clawntl/BLDC-Driver/Hardware/production/bom.csv

Designator | Footprint | Quantity | Value | LCSC Part #
C1, C13, C14, C15, C17, C27, C29, C31, C32 | 0402 | 9 | 100nF | C307331
C10, C11, C26, C28, C3, C30, C6 | 0402 | 7 | 1uF | C52923
C12, C21, C22, C23, C24 | 0805 | 5 | 10uF | C440198
C16 | 0603 | 1 | 10uF | C96446
C18, C19, C20 | 0402 | 3 | 22pF | C1555
C2, C5 | 0603 | 2 | 47nF | C1622
C33, C34 | 0402 | 2 | 10pF | C32949
C4 | 0603 | 1 | 22uF | C59461
C7 | 0805 | 1 | 4.7uF | C1779
C8, C9 | 0402 | 2 | 100pF | C1546
D1 | D_SOD-323 | 1 | 1N4148WS | C2128
D2 | D_SOD-323_Zener | 1 | BZT52B5V1S | C19077434
D3 | 0603 | 1 | Red LED | C2286
D4 | 0603 | 1 | White LED | C2290
IC2 | QFN50P500X700X100-41N-D | 1 | DRV8316CRRGFR | C5447274
J1 | USB_C_Receptacle_GCT_USB4105-xx-A_16P_TopMnt_Horizontal | 1 | USB_C_Receptacle_USB2.0_16P | C393939
J3, J4 | JST_PH_S3B-PH-K_1x03_P2.00mm_Horizontal | 2 | Conn_01x03 | C157929
L1 | L_Changjiang_FNR3015S | 1 | 47uH | C96151
Q1 | SOT-23 | 1 | AO3401A | C15127
R1, R2 | 0805 | 2 | 60.4R | C72998
R10, R13, R16, R7, R9 | 0402 | 5 | 10k | C25744
R11, R12, R14, R15, R18, R19, R6 | 0402 | 7 | 330R | C25104
R17, R8 | 0402 | 2 | 100k | C25741
R3, R4, R5 | 0402 | 3 | 5.1k | C25905
SW1, SW2, SW3 | TS-1088-AR02016 | 3 | TS-1088-AR02016 | C720477
U1 | QFN-48-1EP_7x7mm_P0.5mm_EP5.6x5.6mm | 1 | STM32G431CBUx | C529356
U2 | SOIC-8_3.9x4.9mm_P1.27mm | 1 | TJA1051T-3 | C38695
U4 | SOT-23-3 | 1 | XC6206P332MR-G | C5446
X1 | Crystal_SMD_3225-4Pin_3.2x2.5mm | 1 | SMD3225-4 | C13738
