clawntl/BLDC-Driver/Hardware/DRV8316CRRGFR/DRV8316CRRGFR.step

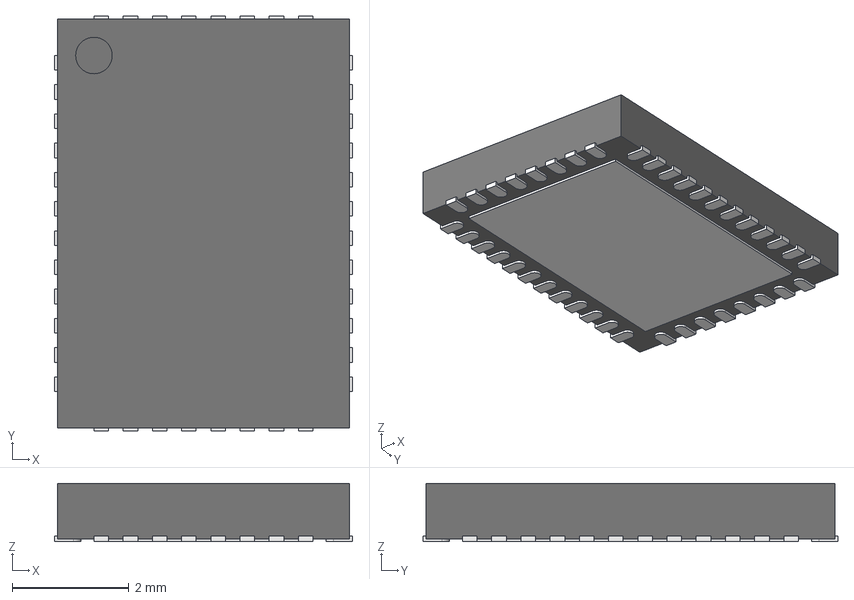
[picture p2: CAD file, 2025-07-08]
Hardware/DRV8316CRRGFR/DRV8316CRRGFR.step
5.10 x 7.10 x 1.00 mm
ThermalPin
PinsArrayLR
PinsArrayTB
