clawntl/BLDC-Driver/Hardware/v0.2_Custom_Motor_Driver_DRV8316_STM32G4.step

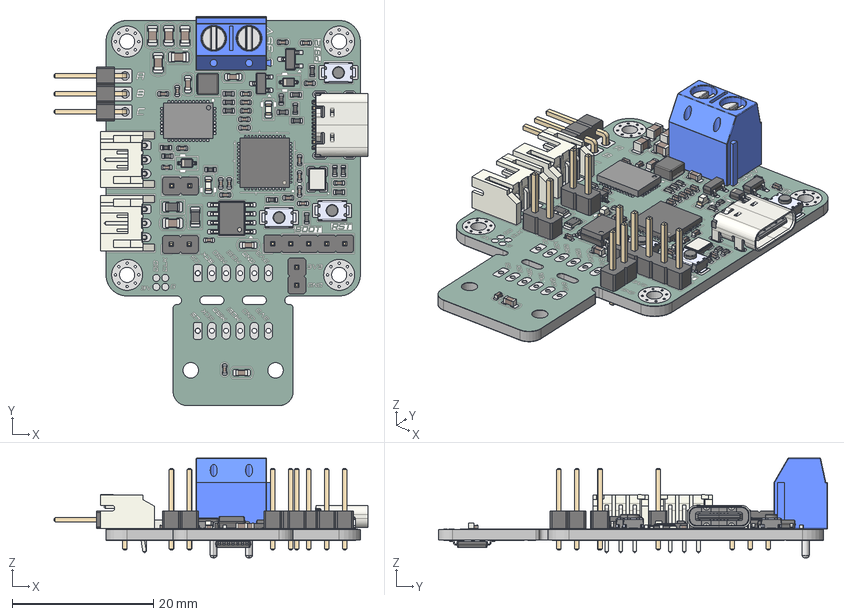
[picture p3: CAD file, 2025-07-08]
Hardware/v0.2_Custom_Motor_Driver_DRV8316_STM32G4.step
44.4 x 55.1 x 14.1 mm
PinHeader_1x05_P2.54mm_Vertical
C_0402_1005Metric x 23
TS-1088-AR02016--3DModel-STEP-269445 x 3
R_0402_1005Metric x 17
ThermalPin
PinsArrayLR
PinsArrayTB
C_0805_2012Metric x 6
R_0805_2012Metric x 2
C_0603_1608Metric x 4
D_SOD-323 x 2
USB_C_Receptacle_GCT_USB4105-xx-A_16P_TopMnt_Horizontal
SOIC-8_3.9x4.9mm_P1.27mm
Crystal_SMD_3225-4Pin_3.2x2.5mm
PinHeader_1x02_P2.54mm_Vertical x 3
LED_0603_1608Metric x 2
JST_PH_S3B-PH-K_1x03_P2.00mm_Horizontal x 2
L_Changjiang_FNR3015S
SOT-23-3
QFN-48-1EP_7x7mm_P0.5mm_EP5.15x5.15mm
SOT-23
PinHeader_1x03_P2.54mm_Horizontal
TSSOP-14_4.4x5mm_P0.65mm
v0.2_Custom_Motor_Driver_DRV8316_STM32G4_copper
v0.2_Custom_Motor_Driver_DRV8316_STM32G4_pad
v0.2_Custom_Motor_Driver_DRV8316_STM32G4_via
v0.2_Custom_Motor_Driver_DRV8316_STM32G4_silkscreen
v0.2_Custom_Motor_Driver_DRV8316_STM32G4_soldermask
v0.2_Custom_Motor_Driver_DRV8316_STM32G4_PCB
