clawntl/BLDC-Driver/schematic_v0.2.pdf

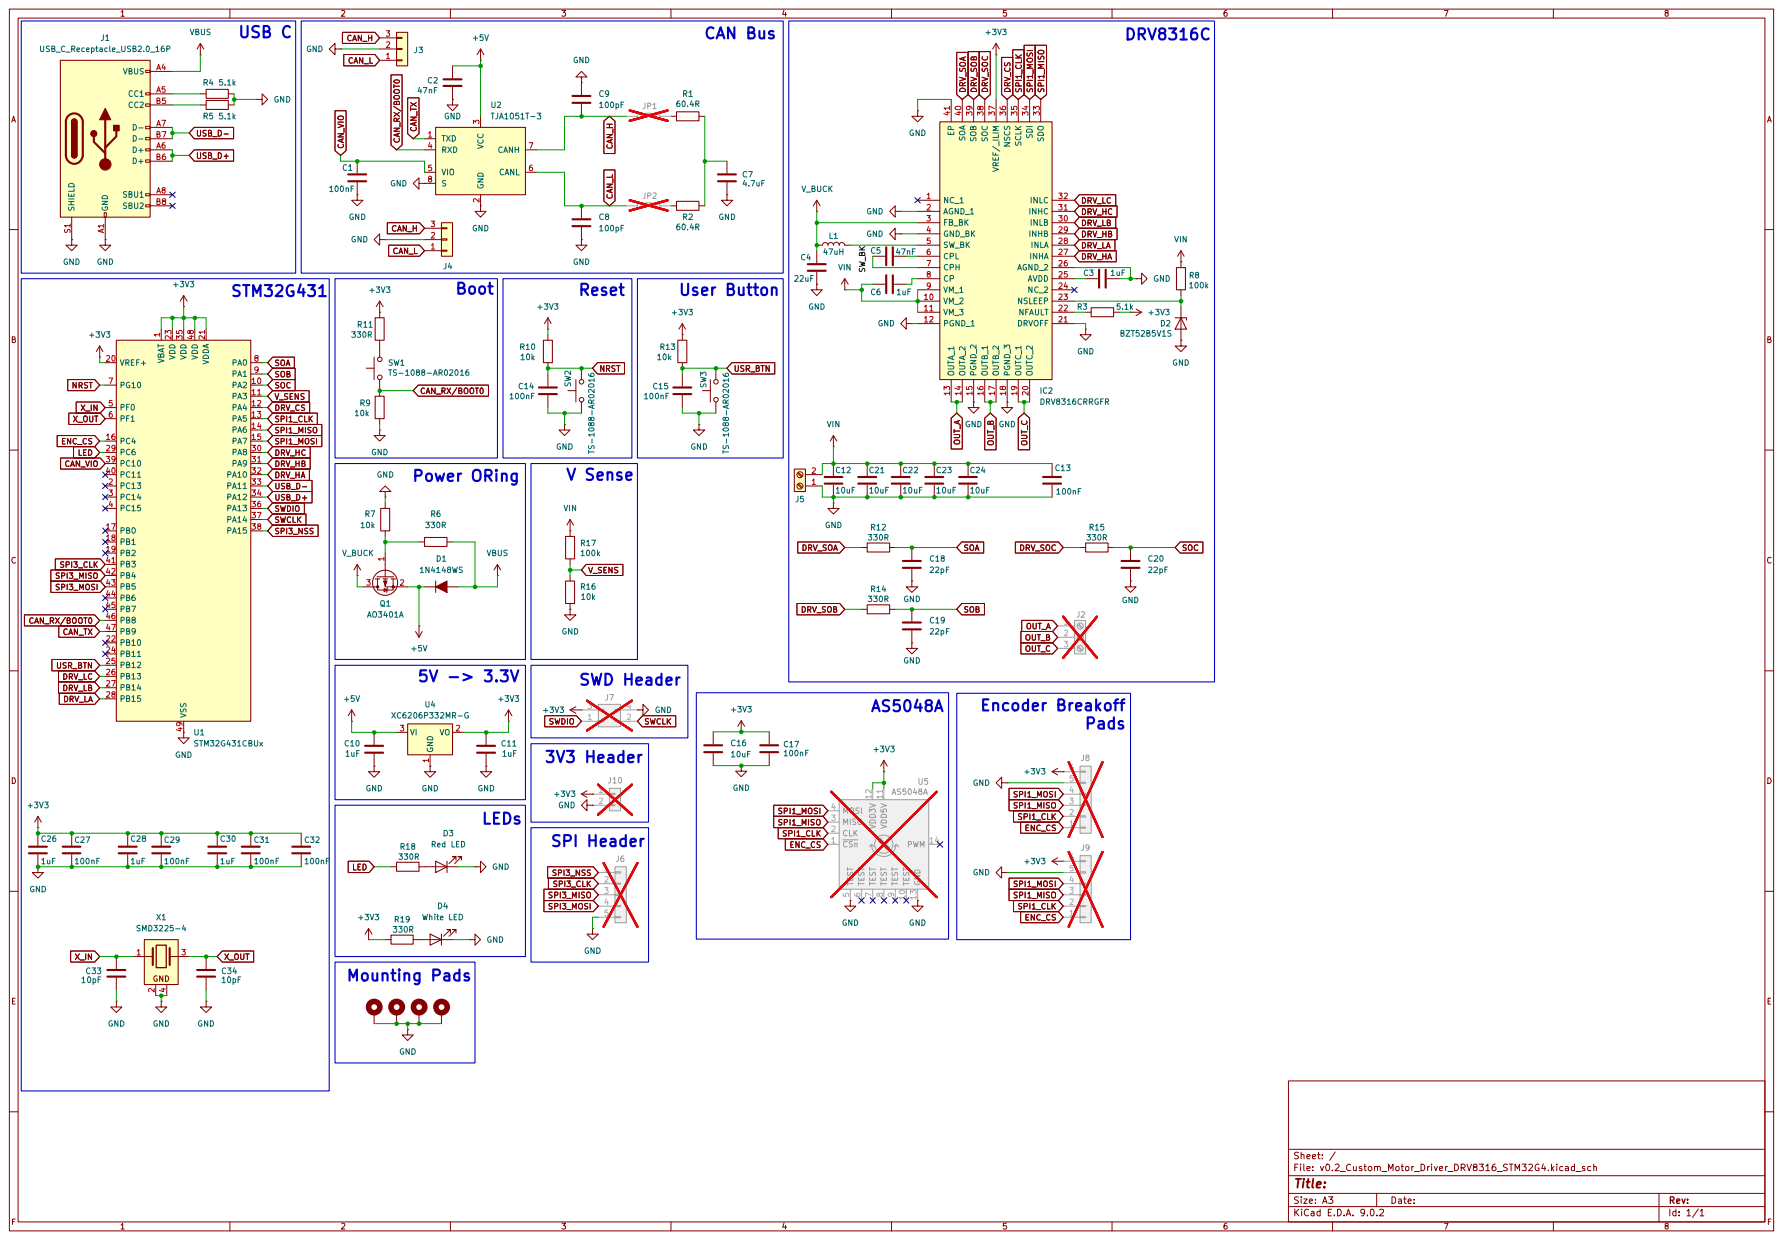
[picture p4: page 1]
