clawntl/BLDC-Driver/Hardware/v0.2_Custom_Motor_Driver_DRV8316_STM32G4.kicad_pcb

## KiCad design Hardware/v0.2_Custom_Motor_Driver_DRV8316_STM32G4.kicad_pcb (2025-07-08)

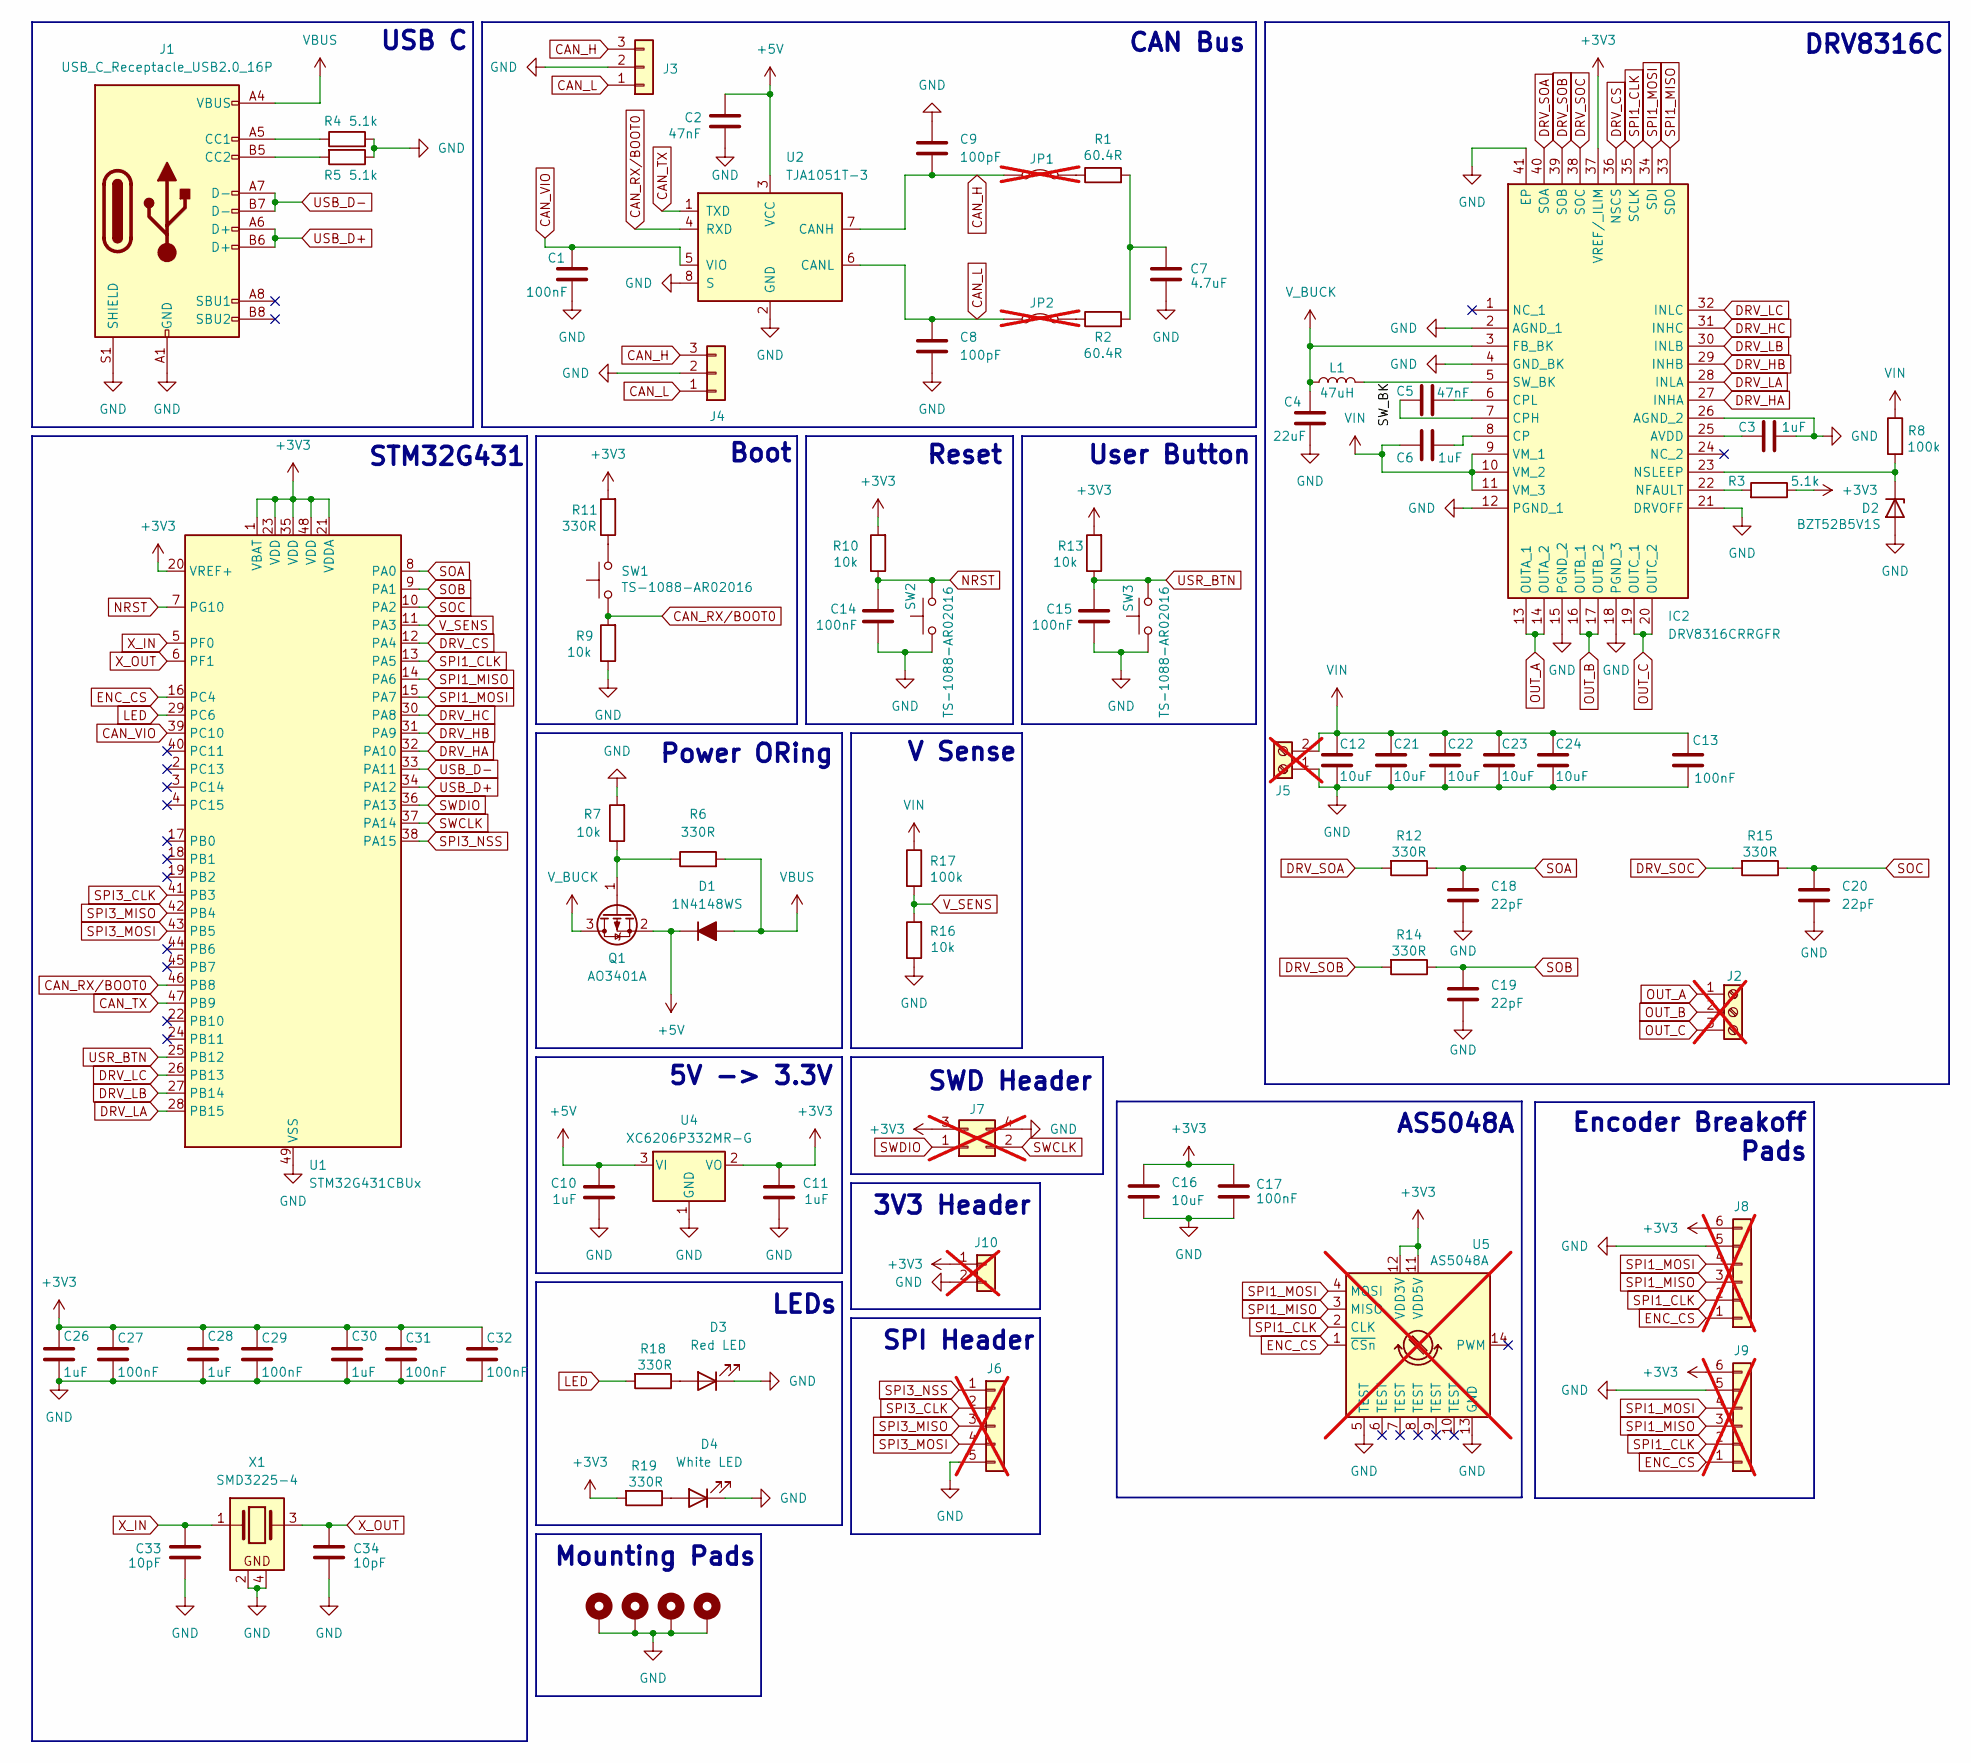
[picture p5: schematic v0.2_Custom_Motor_Driver_DRV8316_STM32G4.kicad_sch]

Parts:
C1, C13, C14, C15, C17, C27, C29, C31, C32: 100nF; C_0402_1005Metric; LCSC C307331
C2, C5: 47nF; C_0603_1608Metric; LCSC C1622
C3, C6, C10, C11, C26, C28, C30: 1uF; C_0402_1005Metric; LCSC C52923
C4: 22uF; C_0603_1608Metric; LCSC C59461
C7: 4.7uF; C_0805_2012Metric; LCSC C1779
C8, C9: 100pF; C_0402_1005Metric; LCSC C1546
C12, C21, C22, C23, C24: 10uF; C_0805_2012Metric; LCSC C440198
C16: 10uF; C_0603_1608Metric; LCSC C96446
C18, C19, C20: 22pF; C_0402_1005Metric; LCSC C1555
C33, C34: 10pF; C_0402_1005Metric; LCSC C32949
D1: 1N4148WS; D_SOD-323; LCSC C2128
D2: BZT52B5V1S; D_SOD-323_Zener; LCSC C19077434
D3: Red LED; LED_0603_1608Metric; LCSC C2286
D4: White LED; LED_0603_1608Metric; LCSC C2290
H1, H2, H3, H4: MountingHole_Pad; MountingHole_2.2mm_M2_Pad_Via
IC2: DRV8316CRRGFR; QFN50P500X700X100-41N-D; LCSC C5447274
J1: USB_C_Receptacle_USB2.0_16P; USB_C_Receptacle_GCT_USB4105-xx-A_16P_TopMnt_Horizontal; LCSC C393939
J2: Screw_Terminal_01x03; TerminalBlock_Xinya_XY308-2.54-3P_1x03_P2.54mm_Horizontal; not fitted
J3, J4: Conn_01x03; JST_PH_S3B-PH-K_1x03_P2.00mm_Horizontal; LCSC C157929
J5: Screw_Terminal_01x02; TerminalBlock_MaiXu_MX126-5.0-02P_1x02_P5.00mm; LCSC C3018698; not fitted
J6: Conn_01x05; PinHeader_1x05_P2.54mm_Vertical; not fitted
J7: Conn_02x02_Odd_Even; DebugHeader2x02_P1.27mm; not fitted
J8, J9: Conn_01x06; JST_PH_S6B-PH-K_1x06_P2.00mm_Horizontal Breakoff; not fitted
J10: Conn_01x02; PinHeader_1x02_P2.54mm_Vertical SLIM; not fitted
JP1, JP2: Jumper_2_Bridged; PinHeader_1x02_P2.54mm_Vertical; not fitted
L1: 47uH; L_Changjiang_FNR3015S; LCSC C96151
Q1: AO3401A; SOT-23; LCSC C15127
R1, R2: 60.4R; R_0805_2012Metric; LCSC C72998
R3, R4, R5: 5.1k; R_0402_1005Metric; LCSC C25905
R6, R11, R12, R14, R15, R18, R19: 330R; R_0402_1005Metric; LCSC C25104
R7, R9, R10, R13, R16: 10k; R_0402_1005Metric; LCSC C25744
R8, R17: 100k; R_0402_1005Metric; LCSC C25741
SW1, SW2, SW3: TS-1088-AR02016; LCSC C720477
U1: STM32G431CBUx; QFN-48-1EP_7x7mm_P0.5mm_EP5.6x5.6mm; LCSC C529356
U2: TJA1051T-3; SOIC-8_3.9x4.9mm_P1.27mm; LCSC C38695
U4: XC6206P332MR-G; SOT-23-3; LCSC C5446
U5: AS5048A; TSSOP-14_4.4x5mm_P0.65mm; not fitted
X1: SMD3225-4; Crystal_SMD_3225-4Pin_3.2x2.5mm; LCSC C13738

Connections:
+3V3: C11.2, C16.1, C17.1, C26.1, C27.1, C28.1, C29.1, C30.1, C31.1, C32.1, IC2.37 (VREF/_ILIM), J7.3, J8.6, J9.6, J10.1, R3.2, R10.2, R11.2, R13.2, R19.2, U1.1 (VBAT), U1.20 (VREF+), U1.21 (VDDA), U1.23 (VDD), U1.35 (VDD), U1.48 (VDD), U4.2 (VO), U5.11 (VDD5V), U5.12 (VDD3V)
+5V: C2.1, C10.2, D1.1 (K), Q1.2 (S), U2.3 (VCC), U4.3 (VI)
/SW_BK: IC2.5 (SW_BK), L1.2
CAN_H: C9.2, J3.3, J4.3, JP1.1 (A), U2.7 (CANH)
CAN_L: C8.1, J3.1, J4.1, JP2.1 (A), U2.6 (CANL)
CAN_RX/BOOT0: R9.2, SW1.1, U1.46 (PB8), U2.4 (RXD)
CAN_TX: U1.47 (PB9), U2.1 (TXD)
CAN_VIO: C1.1, U1.39 (PC10), U2.5 (VIO)
DRV_CS: IC2.36 (NSCS), U1.12 (PA4)
DRV_HA: IC2.27 (INHA), U1.32 (PA10)
DRV_HB: IC2.29 (INHB), U1.31 (PA9)
DRV_HC: IC2.31 (INHC), U1.30 (PA8)
DRV_LA: IC2.28 (INLA), U1.28 (PB15)
DRV_LB: IC2.30 (INLB), U1.27 (PB14)
DRV_LC: IC2.32 (INLC), U1.26 (PB13)
DRV_SOA: IC2.40 (SOA), R12.2
DRV_SOB: IC2.39 (SOB), R14.2
DRV_SOC: IC2.38 (SOC), R15.2
ENC_CS: J8.1, J9.1, U1.16 (PC4), U5.1 (~CSn)
GND: C1.2, C2.2, C3.2, C4.2, C7.2, C8.2, C9.1, C10.1, C11.1, C12.2, C13.2, C14.2, C15.2, C16.2, C17.2, C18.2, C19.2, C20.2, C21.2, C22.2, C23.2, C24.2, C26.2, C27.2, C28.2, C29.2, C30.2, C31.2, C32.2, C33.2, C34.2, D2.2 (A), D3.1 (K), D4.1 (K), H1.1, H2.1, H3.1, H4.1, IC2.2 (AGND_1), IC2.4 (GND_BK), IC2.12 (PGND_1), IC2.15 (PGND_2), IC2.18 (PGND_3), IC2.21 (DRVOFF), IC2.26 (AGND_2), IC2.41 (EP), J1.A1 (GND), J1.A12 (GND), J1.B1 (GND), J1.B12 (GND), J1.S1 (SHIELD), J3.2, J4.2, J5.1, J6.5, J7.4, J8.5, J9.5, J10.2, R4.2, R5.1, R7.2, R9.1, R16.1, SW2.1, SW3.1, U1.49 (VSS), U2.2 (GND), U2.8 (S), U4.1 (GND), U5.5 (TEST), U5.13 (GND), X1.2, X1.4
LED: R18.2, U1.29 (PC6)
NRST: C14.1, R10.1, SW2.2, U1.7 (PG10)
unnamed: C7.1, R1.2, R2.2
unnamed: D2.1 (K), IC2.23 (NSLEEP), R8.1
unnamed: D3.2 (A), R18.1
unnamed: D4.2 (A), R19.1
unnamed: C3.1, IC2.25 (AVDD)
unnamed: C6.2, IC2.8 (CP)
unnamed: C5.1, IC2.7 (CPH)
unnamed: C5.2, IC2.6 (CPL)
unnamed: IC2.22 (NFAULT), R3.1
unnamed: J1.A5 (CC1), R4.1
unnamed: J1.B5 (CC2), R5.2
unnamed: JP1.2 (B), R1.1
unnamed: JP2.2 (B), R2.1
unnamed: Q1.1 (G), R6.1, R7.1
unnamed: R11.1, SW1.2
OUT_A: IC2.13 (OUTA_1), IC2.14 (OUTA_2), J2.1
OUT_B: IC2.16 (OUTB_1), IC2.17 (OUTB_2), J2.2
OUT_C: IC2.19 (OUTC_1), IC2.20 (OUTC_2), J2.3
SOA: C18.1, R12.1, U1.8 (PA0)
SOB: C19.1, R14.1, U1.9 (PA1)
SOC: C20.1, R15.1, U1.10 (PA2)
SPI1_CLK: IC2.35 (SCLK), J8.2, J9.2, U1.13 (PA5), U5.2 (CLK)
SPI1_MISO: IC2.33 (SDO), J8.3, J9.3, U1.14 (PA6), U5.3 (MISO)
SPI1_MOSI: IC2.34 (SDI), J8.4, J9.4, U1.15 (PA7), U5.4 (MOSI)
SPI3_CLK: J6.2, U1.41 (PB3)
SPI3_MISO: J6.3, U1.42 (PB4)
SPI3_MOSI: J6.4, U1.43 (PB5)
SPI3_NSS: J6.1, U1.38 (PA15)
SWCLK: J7.2, U1.37 (PA14)
SWDIO: J7.1, U1.36 (PA13)
USB_D+: J1.A6 (D+), J1.B6 (D+), U1.34 (PA12)
USB_D-: J1.A7 (D-), J1.B7 (D-), U1.33 (PA11)
USR_BTN: C15.1, R13.1, SW3.2, U1.25 (PB12)
VBUS: D1.2 (A), J1.A4 (VBUS), J1.A9 (VBUS), J1.B4 (VBUS), J1.B9 (VBUS), R6.2
VIN: C6.1, C12.1, C13.1, C21.1, C22.1, C23.1, C24.1, IC2.9 (VM_1), IC2.10 (VM_2), IC2.11 (VM_3), J5.2, R8.2, R17.2
V_BUCK: C4.1, IC2.3 (FB_BK), L1.1, Q1.3 (D)
V_SENS: R16.2, R17.1, U1.11 (PA3)
X_IN: C33.1, U1.5 (PF0), X1.1
X_OUT: C34.1, U1.6 (PF1), X1.3

Notes on the sheet:
Power ORing
LEDs
5V -> 3.3V
V Sense
USB C
AS5048A
SWD Header
CAN Bus
SPI Header
STM32G431
Encoder Breakoff Pads
DRV8316C
Reset
3V3 Header
Mounting Pads
User Button
Boot

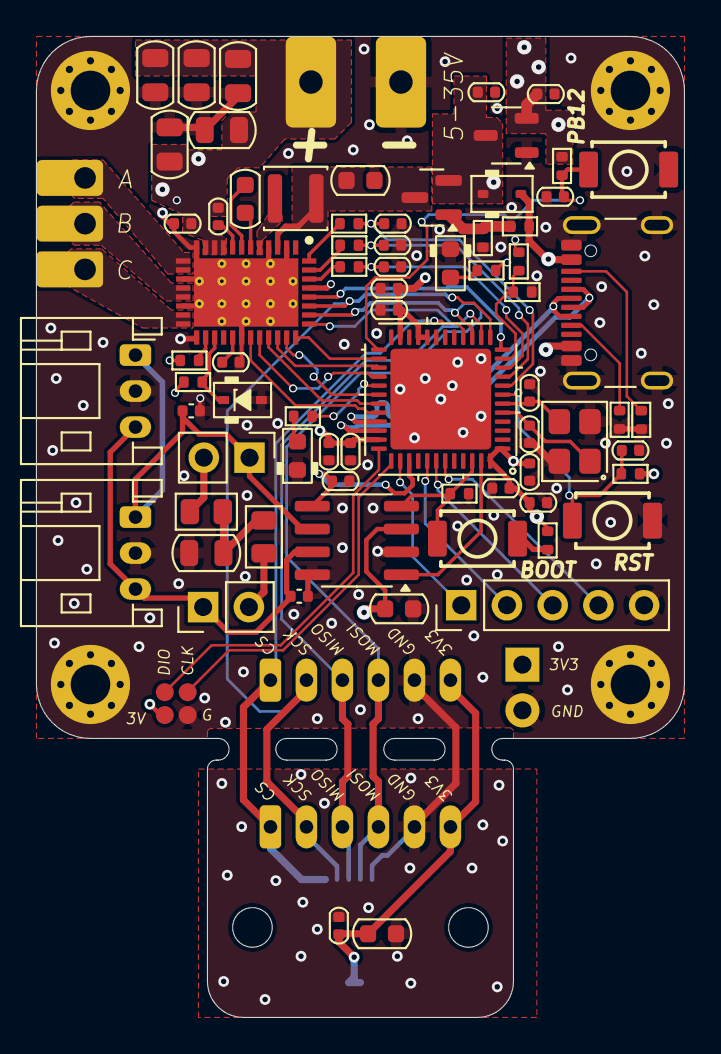
[picture p6: board v0.2_Custom_Motor_Driver_DRV8316_STM32G4.kicad_pcb from above]

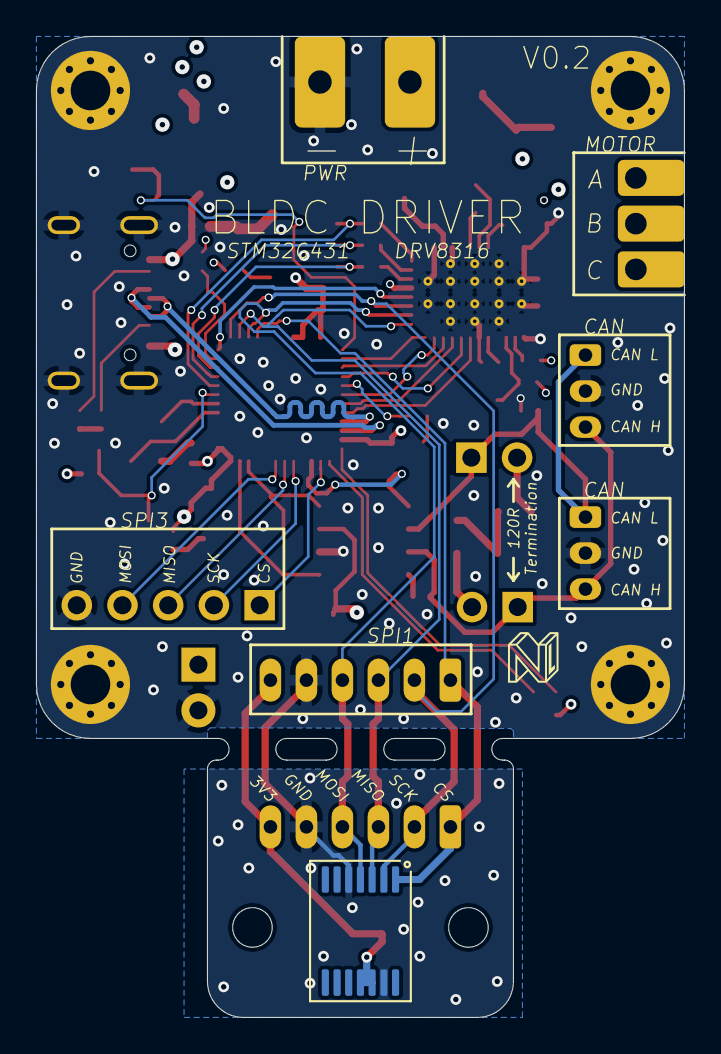
[picture p7: board v0.2_Custom_Motor_Driver_DRV8316_STM32G4.kicad_pcb from below]

Board: 4 copper layers, 36.0 x 54.5 mm, 83 parts (2 on the bottom side), 61 nets.
