clawntl/BLDC-Driver/(commit log)

2025-07-08 Add PCB files
2025-07-08 Added BLDC Driver Pinout Diagram
2025-07-08 Fixed BLDC Driver Pinout Diagram
2025-07-08 Uploaded BLDC Driver Pinout Diagram
2026-11-11 Add driver firmware and motor_test bench firmware
    PlatformIO project for the STM32G431 + DRV8316 board, contributed as a
    snapshot. Two environments:
    - driver: CAN-controlled FOC driver firmware (one image for both left and
    right boards; side, invert and FOC alignment stored in flash and set over
    USB serial, `help` lists commands).
    - motor_test: bench/bring-up firmware for testing the sensor, current sense
    and motor over a USB serial console (no CAN).
    Contributor's notes for the changes included in this snapshot:
    Measure supply voltage at startup; fix SPI chip-select clash
    - Add supply_voltage.h/.cpp: averaged read of the V_SENS divider
    (VIN -> 100k -> PA3 -> 10k -> GND, VIN = V_PA3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
2026-11-11 Expand README and add hardware, firmware and CAN protocol docs
    Rewrite the README with a feature table, repository layout, quick start
    and links to new docs/ pages covering the pin mapping and connectors,
    building/flashing/configuring the firmware, the serial console, the
    bench-test firmware, and the full CAN protocol with a host example.
    Also fix a stale build-environment name in the motor_test header.
    Claude-Session: https://claude.ai/code/session_01DgkXHtgoVyuCpnbtWGknDx
2026-11-11 Fix phase C high pin label in pinout diagram (PA9 -> PA8)
    The pinout image labelled phase C high as PA9, duplicating phase B high.
    The netlist and firmware (pins.h) use PA8. Drop the now-obsolete
    note about the typo from docs/hardware.md.
    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
2026-11-11 Disable the CAN transceiver before software resets so they don't start DFU
    Symptom: after `save` or `reboot` the board went unresponsive: no USB serial port, no CAN, LED off. Only the reset button or a power cycle recovered it.
    Cause: on the STM32G431, PB8 is both BOOT0 and FDCAN1_RX, and BOOT0 is read from the pin as the chip leaves reset. While the CAN transceiver is enabled it drives RX high whenever the bus is idle, even with nothing connected. That overpowers the 10k pull-down on PB8, so a software reset (only microseconds long) samples BOOT0 = 1 and starts the bootloader. The reset button and power-up work because the transceiver is disabled or unpowered by the time BOOT0 is sampled.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
2026-11-11 Add test routines guide for the motor_test firmware
    Step-by-step bench test of a board, motor and encoder: commands, expected readings and motion, and likely causes when a reading is out of range, plus a record sheet. Linked from the README and the firmware guide.
